chrskly/electric-mustang-bms/hardware/bms/bms.kicad_pcb

## KiCad design hardware/bms/bms.kicad_pcb (2024-02-29)

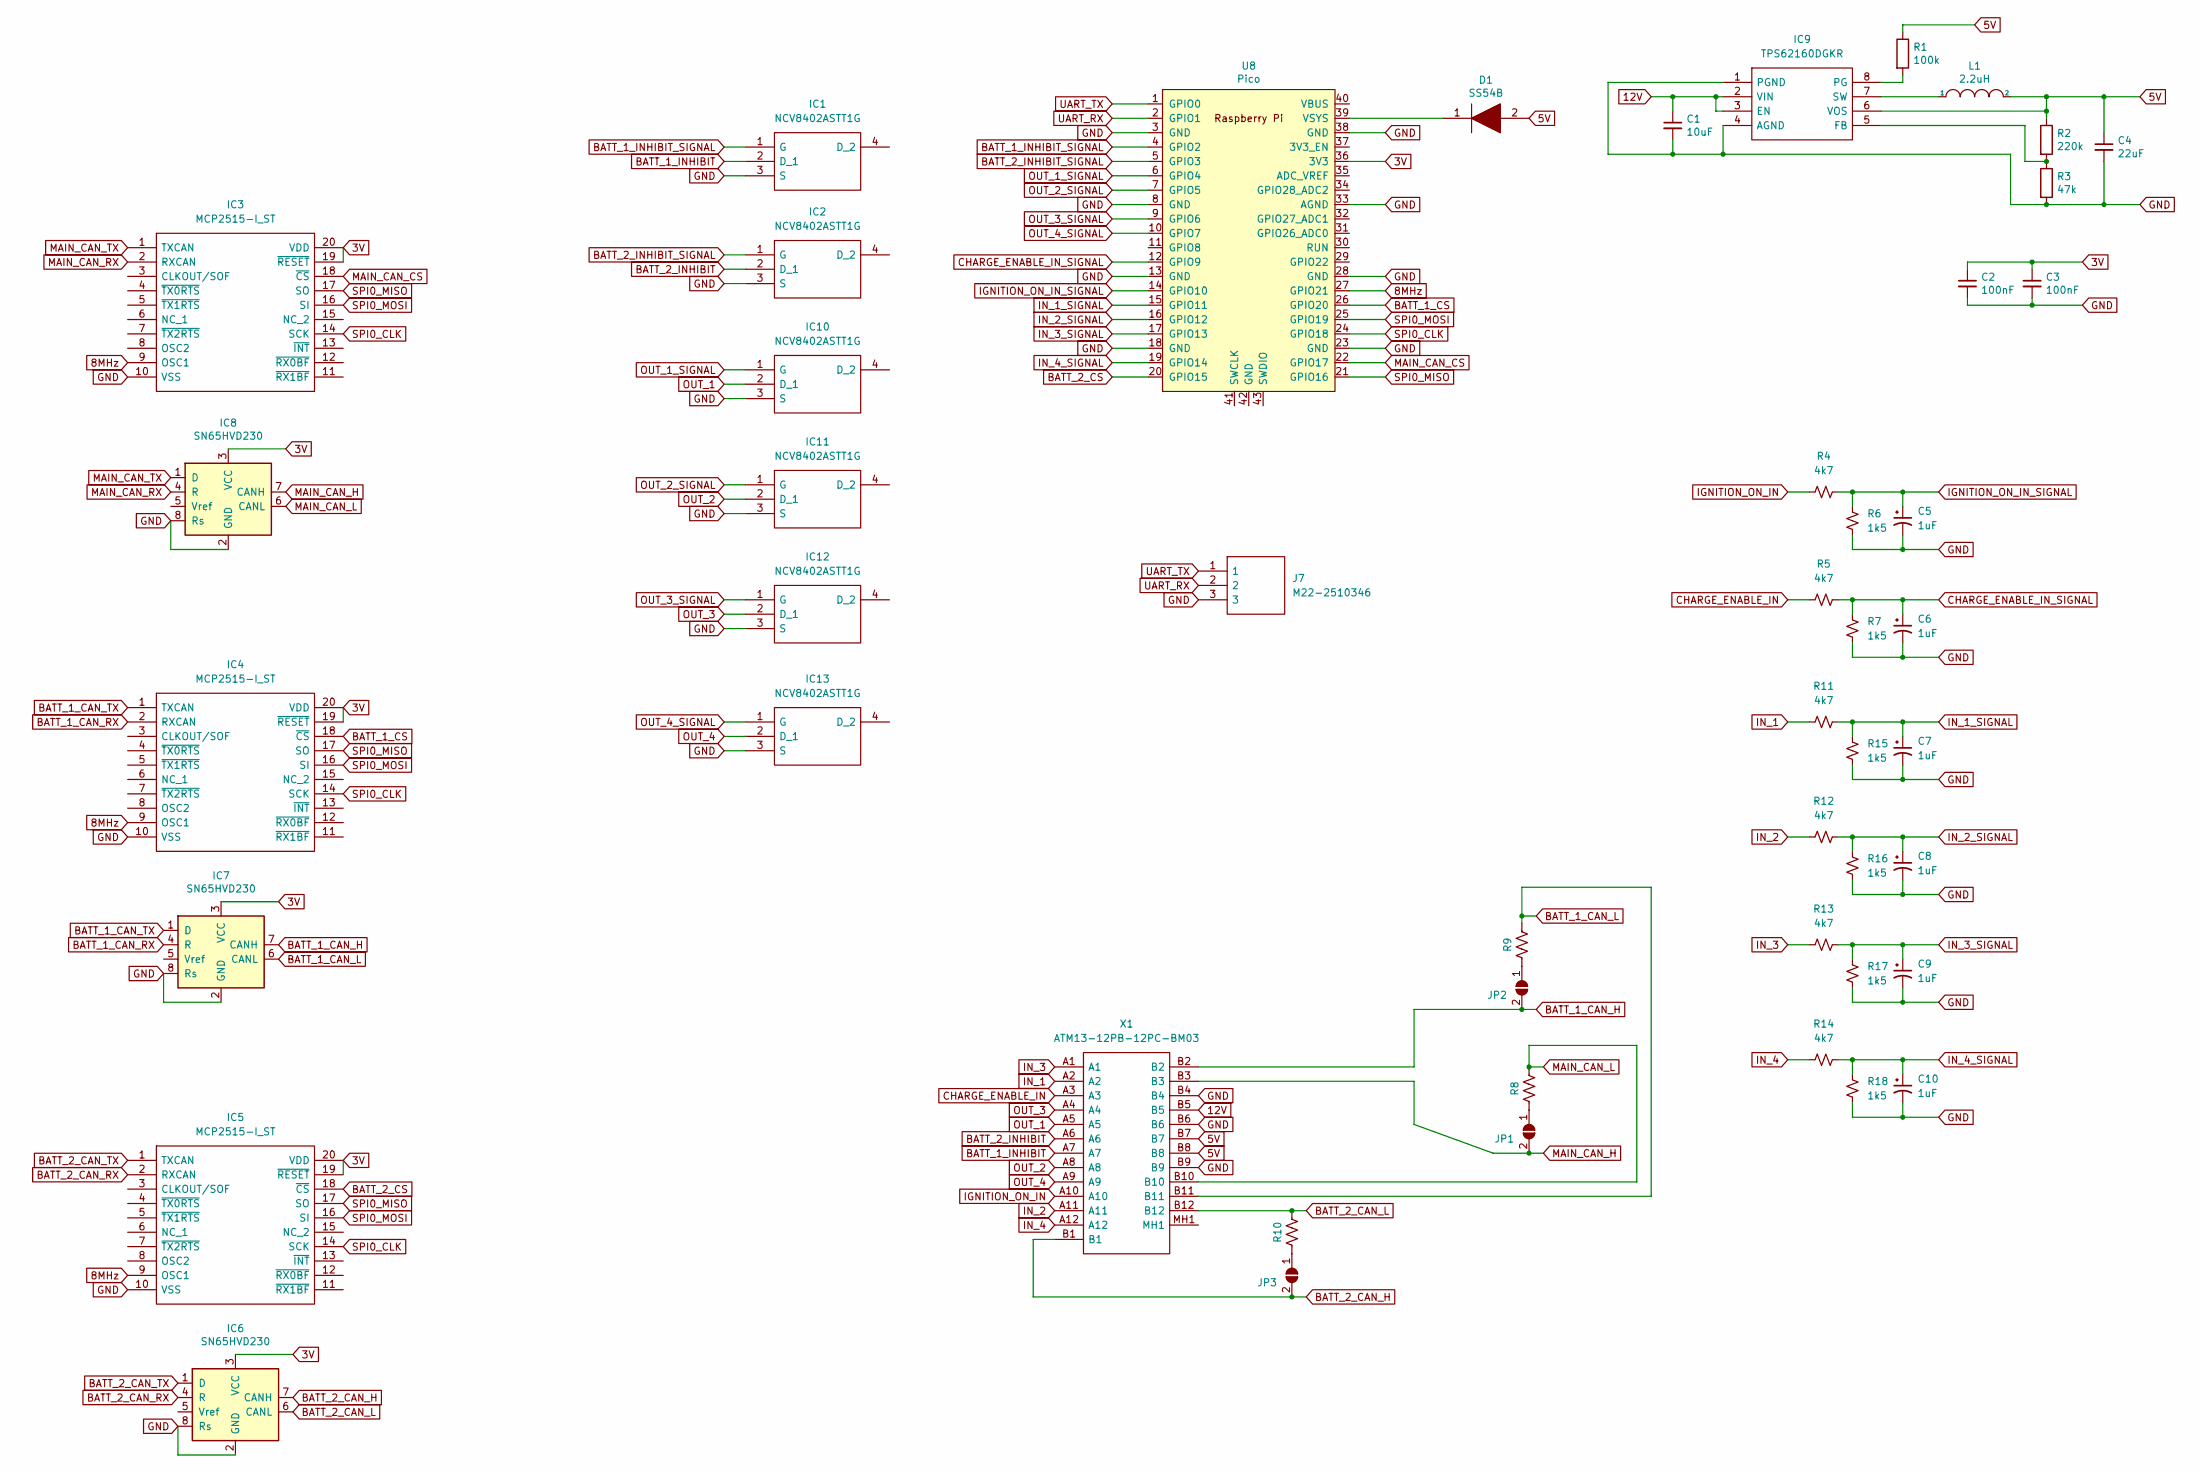
[picture p1: schematic bms.kicad_sch]

Parts:
C1: 10uF; C_0603_1608Metric
C2, C3: 100nF; C_0603_1608Metric
C4: 22uF; C_0805_2012Metric
C5, C6, C7, C8, C9, C10: 1uF; C_0603_1608Metric
D1: SS54B; DIOM5336X244N; Manufacturer_Part_Number SS54B
IC1, IC2, IC10, IC11, IC12, IC13: NCV8402ASTT1G; SOT230P700X175-4N; Manufacturer_Part_Number NCV8402ASTT1G; Mouser Part Number 863-NCV8402ASTT1G
IC3, IC4, IC5: MCP2515-I_ST; SOP65P640X120-20N; Manufacturer_Part_Number MCP2515-I/ST
IC6, IC7, IC8: SN65HVD230; SOIC-8_3.9x4.9mm_P1.27mm
IC9: TPS62160DGKR; SOP65P490X110-8N; Manufacturer_Part_Number TPS62160DGKR; Mouser Part Number 595-TPS62160DGKR
J7: M22-2510346; PinHeader_1x03_P2.54mm_Vertical; Manufacturer_Part_Number M22-2510346; Mouser Part Number 855-M22-2510346
JP1, JP2, JP3: SolderJumper_2_Open; SolderJumper-2_P1.3mm_Open_Pad1.0x1.5mm
L1: 2.2uH; NR6028T220M
R1: 100k; R_0805_2012Metric
R2: 220k; R_0805_2012Metric
R3: 47k; R_0805_2012Metric
R4, R5, R11, R12, R13, R14: 4k7; R_0805_2012Metric
R6, R7, R15, R16, R17, R18: 1k5; R_0805_2012Metric
R8, R9, R10: 120; R_0805_2012Metric
U8: Pico; RPi_Pico_SMD_TH
X1: ATM13-12PB-12PC-BM03; ATM1312PB12PCBM03; Manufacturer_Part_Number ATM13-12PB-12PC-BM03; Mouser Part Number 654-ATM1312B12PCBM03

Connections:
3V: C2.1, C3.1, IC3.19 (~RESET), IC3.20 (VDD), IC4.19 (~RESET), IC4.20 (VDD), IC5.19 (~RESET), IC5.20 (VDD), IC6.3 (VCC), IC7.3 (VCC), IC8.3 (VCC), U8.36 (3V3)
5V: C4.1, D1.2, IC9.6 (VOS), L1.2, R1.1, R2.1, X1.B7, X1.B8
8MHz: IC3.9 (OSC1), IC4.9 (OSC1), IC5.9 (OSC1), U8.27 (GPIO21)
12V: C1.1, IC9.2 (VIN), IC9.3 (EN), X1.B5
BATT_1_CAN_H: IC7.7 (CANH), JP2.2 (B), X1.B2
BATT_1_CAN_L: IC7.6 (CANL), R9.1, X1.B11
BATT_1_CAN_RX: IC4.2 (RXCAN), IC7.4 (R)
BATT_1_CAN_TX: IC4.1 (TXCAN), IC7.1 (D)
BATT_1_CS: IC4.18 (~CS), U8.26 (GPIO20)
BATT_1_INHIBIT: IC1.2 (D_1), X1.A7
BATT_1_INHIBIT_SIGNAL: IC1.1 (G), U8.4 (GPIO2)
BATT_2_CAN_H: IC6.7 (CANH), JP3.2 (B), X1.B1
BATT_2_CAN_L: IC6.6 (CANL), R10.1, X1.B12
BATT_2_CAN_RX: IC5.2 (RXCAN), IC6.4 (R)
BATT_2_CAN_TX: IC5.1 (TXCAN), IC6.1 (D)
BATT_2_CS: IC5.18 (~CS), U8.20 (GPIO15)
BATT_2_INHIBIT: IC2.2 (D_1), X1.A6
BATT_2_INHIBIT_SIGNAL: IC2.1 (G), U8.5 (GPIO3)
CHARGE_ENABLE_IN: R5.1, X1.A3
CHARGE_ENABLE_IN_SIGNAL: C6.1, R5.2, R7.1, U8.12 (GPIO9)
GND: C1.2, C2.2, C3.2, C4.2, C5.2, C6.2, C7.2, C8.2, C9.2, C10.2, IC1.3 (S), IC2.3 (S), IC3.10 (VSS), IC4.10 (VSS), IC5.10 (VSS), IC6.2 (GND), IC6.8 (Rs), IC7.2 (GND), IC7.8 (Rs), IC8.2 (GND), IC8.8 (Rs), IC9.1 (PGND), IC9.4 (AGND), IC10.3 (S), IC11.3 (S), IC12.3 (S), IC13.3 (S), J7.3, R3.2, R6.2, R7.2, R15.2, R16.2, R17.2, R18.2, U8.3 (GND), U8.8 (GND), U8.13 (GND), U8.18 (GND), U8.23 (GND), U8.28 (GND), U8.33 (AGND), U8.38 (GND), X1.B4, X1.B6, X1.B9
IGNITION_ON_IN: R4.1, X1.A10
IGNITION_ON_IN_SIGNAL: C5.1, R4.2, R6.1, U8.14 (GPIO10)
IN_1: R11.1, X1.A2
IN_1_SIGNAL: C7.1, R11.2, R15.1, U8.15 (GPIO11)
IN_2: R12.1, X1.A11
IN_2_SIGNAL: C8.1, R12.2, R16.1, U8.16 (GPIO12)
IN_3: R13.1, X1.A1
IN_3_SIGNAL: C9.1, R13.2, R17.1, U8.17 (GPIO13)
IN_4: R14.1, X1.A12
IN_4_SIGNAL: C10.1, R14.2, R18.1, U8.19 (GPIO14)
MAIN_CAN_CS: IC3.18 (~CS), U8.22 (GPIO17)
MAIN_CAN_H: IC8.7 (CANH), JP1.2 (B), X1.B3
MAIN_CAN_L: IC8.6 (CANL), R8.1, X1.B10
MAIN_CAN_RX: IC3.2 (RXCAN), IC8.4 (R)
MAIN_CAN_TX: IC3.1 (TXCAN), IC8.1 (D)
unnamed: D1.1, U8.39 (VSYS)
unnamed: IC9.5 (FB), R2.2, R3.1
unnamed: IC9.7 (SW), L1.1
unnamed: IC9.8 (PG), R1.2
unnamed: JP1.1 (A), R8.2
unnamed: JP2.1 (A), R9.2
unnamed: JP3.1 (A), R10.2
OUT_1: IC10.2 (D_1), X1.A5
OUT_1_SIGNAL: IC10.1 (G), U8.6 (GPIO4)
OUT_2: IC11.2 (D_1), X1.A8
OUT_2_SIGNAL: IC11.1 (G), U8.7 (GPIO5)
OUT_3: IC12.2 (D_1), X1.A4
OUT_3_SIGNAL: IC12.1 (G), U8.9 (GPIO6)
OUT_4: IC13.2 (D_1), X1.A9
OUT_4_SIGNAL: IC13.1 (G), U8.10 (GPIO7)
SPI0_CLK: IC3.14 (SCK), IC4.14 (SCK), IC5.14 (SCK), U8.24 (GPIO18)
SPI0_MISO: IC3.17 (SO), IC4.17 (SO), IC5.17 (SO), U8.21 (GPIO16)
SPI0_MOSI: IC3.16 (SI), IC4.16 (SI), IC5.16 (SI), U8.25 (GPIO19)
UART_RX: J7.2, U8.2 (GPIO1)
UART_TX: J7.1, U8.1 (GPIO0)

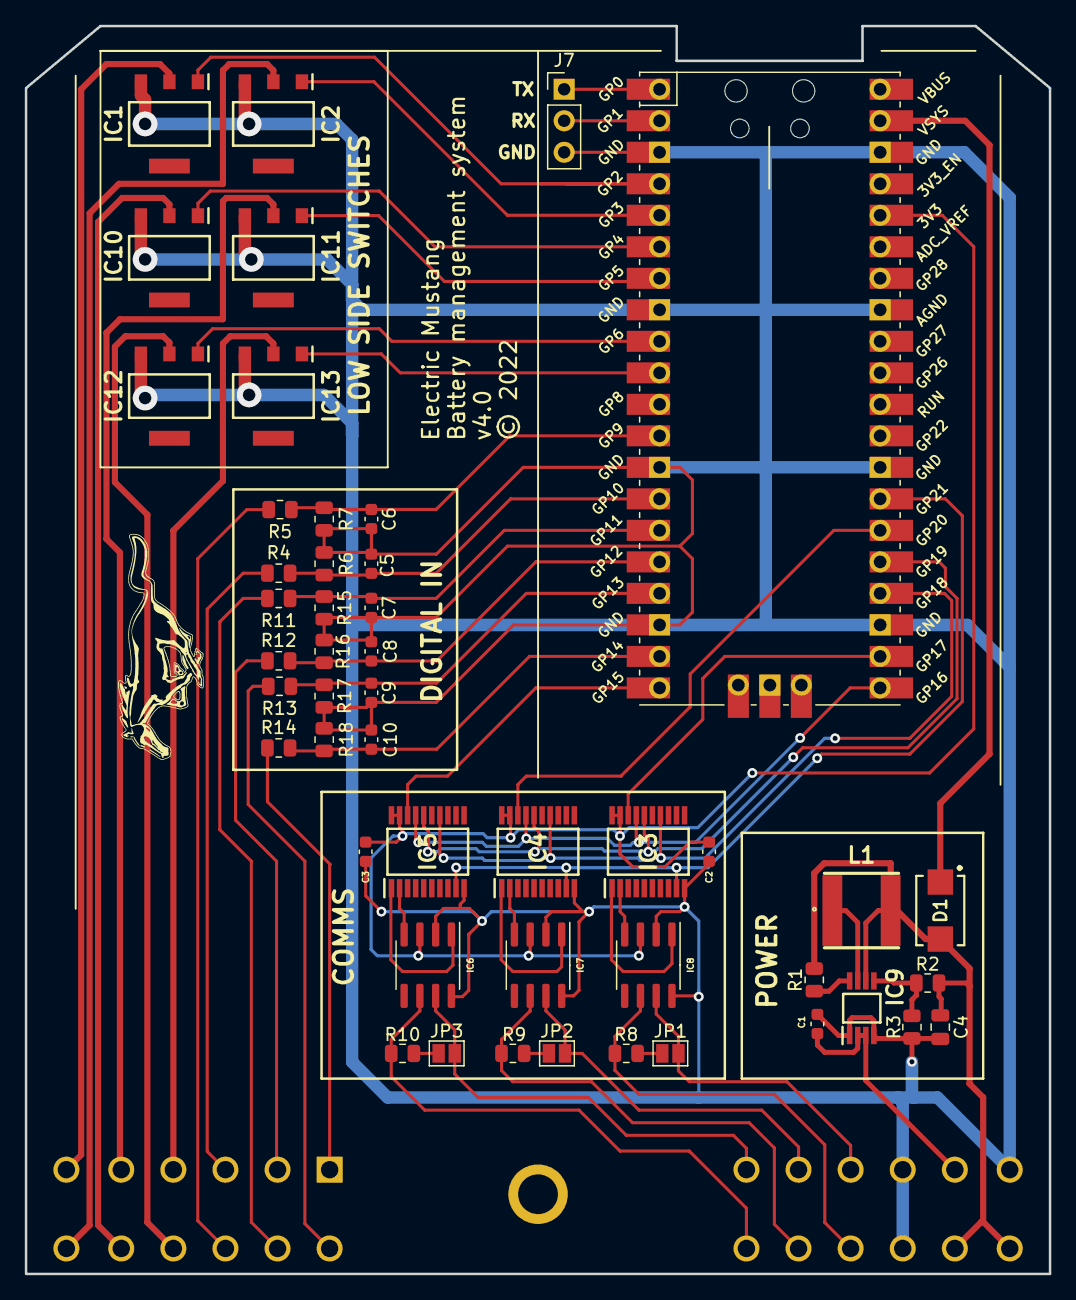
[picture p2: board bms.kicad_pcb from above]

Board: 2 copper layers, 82.6 x 100.6 mm, 49 parts (0 on the bottom side), 56 nets.
