chrskly/electric-mustang-bms/src/module.cpp

/*
 * This file is part of the ev mustang bms project.
 *
 * Copyright (C) 2024 Christian Kelly <chrskly@chrskly.com>
 *
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
 * You should have received a copy of the GNU General Public License
 * along with this program.  If not, see <http://www.gnu.org/licenses/>.
 */

/*

    MODULE

*/

#include <stdio.h>
#include <time.h>

#include "include/module.h"
#include "include/pack.h"
#include "include/util.h"


BatteryModule::BatteryModule() {}

//
BatteryModule::BatteryModule(int _id, BatteryPack* _pack, int _numCells, int _numTemperatureSensors) {
    // printf("Creating module (id:%d, pack:%d, cpm:%d, t:%d)\n", _id, _pack->id, _numCells, _numTemperatureSensors);
    id = _id;
    // Point back to parent pack
    pack = _pack;
    // Initialise all cell voltages to zero
    numCells = _numCells;
    for ( int c = 0; c < numCells; c++ ) {
        cellVoltage[c] = 0;
    }
    // Initialise temperature sensor readings to zero
    numTemperatureSensors = _numTemperatureSensors;
    for ( int t = 0; t < numTemperatureSensors; t++ ) {
        cellTemperature[t] = -127;
    }
    allModuleDataPopulated = false;
}

void BatteryModule::print() {
    // printf("    Module id : %d (numCells : %d)\n", id, numCells);
    // printf("        Cell Voltages : ");
    // for ( int c = 0; c < numCells; c++ ) {
    //     printf("%d:%umV ", c, cellVoltage[c]);
    // }
    // printf("\n");
    // printf("        Temperatures : ");
    // for ( int t = 0; t < numTemperatureSensors; t++ ) {
    //     printf("%d:%dC ", t, cellTemperature[t]);
    // }
    // printf("\n");
    printf("  %d : ", id);
    for ( int c = 0; c < numCells; c++ ) {
        printf("%u ", cellVoltage[c]);
    }
    printf("\n");
}


//// ----
//
// Voltage
//
//// ----

// Return total module voltage by summing the cell voltages
uint32_t BatteryModule::get_voltage() {
    uint32_t voltage = 0;
    for ( int c = 0; c < numCells; c++ ) {
        voltage += cellVoltage[c];
    }
    return voltage;
}

// Return the voltage of the lowest cell voltage in the module
uint16_t BatteryModule::get_lowest_cell_voltage() {
    uint16_t lowestCellVoltage = 10000;
    for ( int c = 0; c < numCells; c++ ) {
        if ( cellVoltage[c] < lowestCellVoltage ) {
            lowestCellVoltage = cellVoltage[c];
        }
    }
    return lowestCellVoltage;
}

// Return the voltage of the highest cell in the module
uint16_t BatteryModule::get_highest_cell_voltage() {
    uint16_t highestCellVoltage = 0;
    for ( int c = 0; c < numCells; c++ ) {
        if ( cellVoltage[c] > highestCellVoltage ) {
            highestCellVoltage = cellVoltage[c];
        }
    }
    return highestCellVoltage;
}

// Update the voltage for a single cell
void BatteryModule::set_cell_voltage(int cellIndex, uint16_t newCellVoltage) {
    cellVoltage[cellIndex] = newCellVoltage;
}

// Return true if any of the cells in the module are under min voltage
bool BatteryModule::has_empty_cell() {
    for ( int c = 0; c < numCells; c++ ) {
        if ( cellVoltage[c] <= CELL_EMPTY_VOLTAGE ) {
            return true;
        }
    }
    return false;
}

// Return true if any of the cells in the module are over max voltage
bool BatteryModule::has_full_cell() {
    for ( int c = 0; c < numCells; c++ ) {
        if ( cellVoltage[c] >= CELL_FULL_VOLTAGE ) {
            return true;
        }
    }
    return false;
}

/*
 * Check for dead cells in the module
 */
bool BatteryModule::has_dead_cell() {
    for ( int c = 0; c < numCells; c++ ) {
        if ( cellVoltage[c] <= DEAD_CELL_VOLTAGE ) {
            return true;
        }
    }
    return false;
}

//// ----
//
// Status
//
//// ----

// Return true if we have voltage/temp information for all cells
bool BatteryModule::all_module_data_populated() {
    return allModuleDataPopulated;
}

void BatteryModule::check_if_module_data_is_populated() {
    bool voltageMissing = false;
    for ( int c = 0; c < numCells; c++ ) {
        if ( cellVoltage[c] == 0 ) {
            voltageMissing = true;
        }
    }
    bool temperatureMissing = false;
    for ( int t = 0; t < numTemperatureSensors; t++ ) {
        if ( cellTemperature[t] < -126 ) {
            temperatureMissing = true;
        }
    }
    allModuleDataPopulated = voltageMissing && temperatureMissing;
}

bool BatteryModule::is_alive() {
    return ( ((double)(get_clock() - lastHeartbeat) / CLOCKS_PER_SEC) < MODULE_TTL );
}

void BatteryModule::heartbeat() {
    lastHeartbeat = get_clock();
}

//// ----
//
// Temperature
//
//// ----

// Update the value for one of the temperature sensors
void BatteryModule::update_temperature(int tempSensorId, uint8_t newTemperature) {
    cellTemperature[tempSensorId] = newTemperature;
}

// Return the temperature of the coldest sensor in the module
int8_t BatteryModule::get_lowest_temperature() {
    int8_t lowestTemperature = 126;
    for ( int t = 0; t < numTemperatureSensors; t++ ) {
        // Skip uninitialised readings
        if ( cellTemperature[t] < -126 ) {
            continue;
        }
        if ( cellTemperature[t] < lowestTemperature ) {
            lowestTemperature = cellTemperature[t];
        }
    }
    //printf("lowest temp : %d\n", lowestTemperature);
    return lowestTemperature;
}

// Return the temperature of the hottest sensor in the module
int8_t BatteryModule::get_highest_temperature() {
    int8_t highestTemperature = -126;
    for ( int t = 0; t < numTemperatureSensors; t++ ) {
        // Skip uninitialised readings
        if ( cellTemperature[t] < -126 ) {
            continue;
        }
        if ( cellTemperature[t] > highestTemperature ) {
            highestTemperature = cellTemperature[t];
        }
    }
    return highestTemperature;
}

// Return true if any temperature sensor is over the max temperature
bool BatteryModule::has_temperature_sensor_over_max() {
    return ( get_highest_temperature() > MAXIMUM_TEMPERATURE );
}



// returns true when any temperature sensor in this module is over the warning
// level, but below the critical level.
bool BatteryModule::temperature_at_warning_level() {
    for ( int c = 0; c < numCells; c++ ) {
        if ( cellTemperature[c] >= WARNING_TEMPERATURE && cellTemperature[c] < MAXIMUM_TEMPERATURE ) {
            return true;
        }
    }
    return false;
}
