chrskly/electric-mustang-bms/test/testcases0xx.cpp

/*
 * This file is part of the ev mustang bms project.
 *
 * Copyright (C) 2024 Christian Kelly <chrskly@chrskly.com>
 *
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
 * You should have received a copy of the GNU General Public License
 * along with this program.  If not, see <http://www.gnu.org/licenses/>.
 */

#include "include/battery.h"
#include "include/io.h"
#include "include/testcaseutils.h"

/*
 * Test cases relating battery empty/full events
 *
 * 001 : Ensure car cannot be driven when battery is empty, starting in STANDBY
 *       state.
 * 002 : Ensure car cannot be driven when battery is empty, starting in DRIVE
 *       state.
 * 003 : When battery is empty and overheating, but the temperature drops, the
 *       car should still not be drivable as the battery is still empty.
 * 004 : When battery is empty and overheating, but the SoC rises the car should
 *       still not be drivable as the battery is still too hot.
 * 005 : When battery is empty and we're charging, but the charging stops, the
 *       car should still not be drivable as the battery is still empty.
 * 006 : When battery is full, the car should not be allowed to charge. Start in
 *       STANDBY state.
 * 007 : When battery is full, the car should not be allowed to charge. Start in
 *       DRIVE state.
 * 008 : When battery is full, the car should not be allowed to charge. Start in
 *       CHARGE state.
 */


/*
 * Test case 001
 * -----------------------------------------------------------------------------
 * Description: Ensure car cannot be driven when battery is empty, starting in
 *              STANDBY state.
 * Preconditions:
 *   1. Battery is not empty
 *   2. BMS is in STANDBY state
 *   3. DRIVE_INHIBIT signal is inactive
 *   4. Temperature is normal
 *   5. Ignition is off
 * Actions:
 *   1. Set cell voltage for one cell to minV (i.e., set battery empty)
 * Postconditions:
 *   1. BMS is in batteryEmpty state
 *   2. DRIVE_INHIBIT signal is active
 */
bool test_case_001(Battery* battery, Bms* bms) {
    printf("Running test [test_case_001] : inhibit drive when battery empty, from idle state\n");

    if ( ! transition_to_standby_state(bms) ) {
        return false;
    }

    // 0% SoC
    uint16_t newCellVoltage = static_cast<uint16_t>(CELL_EMPTY_VOLTAGE);
    printf("    > Setting all cell voltages to %dmV (0%% soc)\n", newCellVoltage);
    battery->set_all_cell_voltages(newCellVoltage);

    // Make sure DRIVE_INHIBIT goes high
    printf("    > Waiting for DRIVE_INHIBIT to activate\n");
    if ( ! assert_drive_inhibit_state(bms, true) ) {
        printf("    > Test FAILED\n");
        return false;
    }

    // Make sure CAN messages show the car has switched to batteryEmpty state
    printf("    > Waiting for BMS state to change to batteryEmpty\n");
    if ( ! assert_bms_state(bms, STATE_BATTERY_EMPTY) ) {
        printf("    > Test FAILED\n");
        return false;
    }

    printf("    > Test PASSED\n");
    return true;
}

/*
 * Test case 002
 * -----------------------------------------------------------------------------
 * Description: Ensure car cannot be driven when battery is empty, starting in
 *              DRIVE state.
 * Preconditions:
 *   1. Battery is not empty
 *   2. BMS is in DRIVE state
 *   3. DRIVE_INHIBIT signal is inactive
 *   4. Temperature is normal
 *   5. Ignition is on
 * Actions:
 *   1. Set cell voltage for one cell to minV
 * Postconditions:
 *   1. BMS is in batteryEmpty state
 *   2. DRIVE_INHIBIT signal is active
 */
bool test_case_002(Battery* battery, Bms* bms) {
    printf("Running test [test_case_002] : inhibit drive when battery empty, from drive state\n");

    if ( ! transition_to_drive_state(bms) ) {
        return false;
    }

    // 0% SoC
    uint16_t newCellVoltage = static_cast<uint16_t>(CELL_EMPTY_VOLTAGE);
    printf("    > Setting all cell voltages to %dmV (0%% soc)\n", newCellVoltage);
    battery->set_all_cell_voltages(newCellVoltage);

    // Make sure DRIVE_INHIBIT goes high
    printf("    > Waiting for DRIVE_INHIBIT to activate\n");
    if ( ! assert_drive_inhibit_state(bms, true) ) {
        printf("    > Test FAILED\n");
        return false;
    }

    // Make sure CAN messages show the car has switched to batteryEmpty state
    printf("    > Waiting for BMS state to change to batteryEmpty\n");
    if ( ! assert_bms_state(bms, STATE_BATTERY_EMPTY) ) {
        printf("    > Test FAILED\n");
        return false;
    }

    printf("    > Test PASSED\n");
    return true;

}

/*
 * Test case 003
 * -----------------------------------------------------------------------------
 * Description: When battery is empty and overheating, but the temperature
 *              drops, the car should still not be drivable as the battery is
 *              still empty.
 * Preconditions:
 *   1. Battery is empty
 *   2. BMS is in overTemp state
 *   3. DRIVE_INHIBIT signal is active
 *   4. Temperature is high
 * Actions:
 *   1. Set temperature to normal value
 * Postconditions:
 *   1. BMS is in batteryEmpty state
 *   2. DRIVE_INHIBIT signal is still active
 */
bool test_case_003(Battery* battery, Bms* bms) {
    printf("Running test [test_case_003] : empty battery, high temp drops\n");

    if ( ! transition_to_standby_state(bms) ) {
        return false;
    }

    // 0% SoC
    uint16_t newCellVoltage = static_cast<uint16_t>(CELL_EMPTY_VOLTAGE);
    printf("    > Setting all cell voltages to %dmV (0%% soc)\n", newCellVoltage);
    battery->set_all_cell_voltages(newCellVoltage);

    // Make sure DRIVE_INHIBIT goes high
    printf("    > Waiting for DRIVE_INHIBIT to activate\n");
    if ( ! assert_drive_inhibit_state(bms, true) ) {
        printf("    > Test FAILED\n");
        return false;
    }

    // Set the temperature to 51C
    printf("    > Setting all temperatures to 51C\n");
    battery->set_all_temperatures(51);

    // wait for overTemp state
    printf("    > Waiting for BMS state to change to overTemp\n");
    if ( ! assert_bms_state(bms, STATE_OVER_TEMP_FAULT) ) {
        printf("    > Test FAILED\n");
        return false;
    }

    // Set the temperature to 20C
    printf("    > Setting all temperatures to 20C\n");
    battery->set_all_temperatures(20);

    // Make sure CAN messages show the car has switched to batteryEmpty state
    printf("    > Waiting for BMS state to change to batteryEmpty\n");
    if ( ! assert_bms_state(bms, STATE_BATTERY_EMPTY) ) {
        printf("    > Test FAILED\n");
        return false;
    }

    // Make sure DRIVE_INHIBIT stays high
    printf("    > Waiting for DRIVE_INHIBIT to activate\n");
    if ( ! assert_drive_inhibit_state(bms, true) ) {
        printf("    > Test FAILED\n");
        return false;
    }

    printf("    > Test PASSED\n");
    return true;

}

/*
 * Test case 004
 * -----------------------------------------------------------------------------
 * Description: When battery is empty and overheating, but the SoC rises the car
 *              should still not be drivable as the battery is still too hot.
 *
 * Preconditions:
 *   1. Battery is empty
 *   2. BMS is in overTemp state
 *   3. DRIVE_INHIBIT signal is active
 *   4. Temperature is high
 * Actions:
 *   1. Set battery SoC to 50%
 * Postconditions:
 *   1. BMS is in overTemp state
 *   2. DRIVE_INHIBIT signal is still active
 */
bool test_case_004(Battery* battery, Bms* bms) {
    printf("Running test [test_case_004] : high temp, empty battery, SoC rises\n");

    if ( ! transition_to_standby_state(bms) ) {
        return false;
    }

    // 0% SoC
    uint16_t newCellVoltage = static_cast<uint16_t>(CELL_EMPTY_VOLTAGE);
    printf("    > Setting all cell voltages to %dmV (0%% soc)\n", newCellVoltage);
    battery->set_all_cell_voltages(newCellVoltage);

    // Make sure DRIVE_INHIBIT goes high
    printf("    > Waiting for DRIVE_INHIBIT to activate\n");
    if ( ! assert_drive_inhibit_state(bms, true) ) {
        printf("    > Test FAILED\n");
        return false;
    }

    // Set the temperature to 51C
    printf("    > Setting all temperatures to 51C\n");
    battery->set_all_temperatures(51);

    // wait for overTemp state
    printf("    > Waiting for BMS state to change to overTemp\n");
    if ( ! assert_bms_state(bms, STATE_OVER_TEMP_FAULT) ) {
        printf("    > Test FAILED\n");
        return false;
    }

    // 50% SoC
    newCellVoltage = battery->get_voltage_from_soc(50);
    printf("    > Setting all cell voltages to %dmV (0%% soc)\n", newCellVoltage);
    battery->set_all_cell_voltages(newCellVoltage);

    // Make sure CAN messages show the car has switched to overTemp state
    printf("    > Waiting for BMS state to change to overTemp\n");
    if ( ! assert_bms_state(bms, STATE_OVER_TEMP_FAULT) ) {
        printf("    > Test FAILED\n");
        return false;
    }

    // Make sure DRIVE_INHIBIT stays high
    printf("    > Waiting for DRIVE_INHIBIT to activate\n");
    if ( ! assert_drive_inhibit_state(bms, true) ) {
        printf("    > Test FAILED\n");
        return false;
    }

    printf("    > Test PASSED\n");
    return true;

}

/*
 * Test case 005
 * -----------------------------------------------------------------------------
 * Description: When battery is empty and we're charging, but the charging
 *              stops, the car should still not be drivable as the battery is
 *              still empty.
 * Preconditions:
 *   1. Battery is empty
 *   2. BMS is in STANDBY state
 *   3. DRIVE_INHIBIT signal is inactive
 *   4. Temperature is normal
 * Actions:
 *   1. Start charging
 *   2. Stop charging
 * Postconditions:
 *   1. BMS is in batteryEmpty state
 *   2. DRIVE_INHIBIT signal is still active
 */
bool test_case_005(Battery* battery, Bms* bms) {
    printf("Running test [test_case_005] : empty battery, charging terminates\n");

    if ( ! transition_to_standby_state(bms) ) {
        return false;
    }

    // 0% SoC
    uint16_t newCellVoltage = static_cast<uint16_t>(CELL_EMPTY_VOLTAGE);
    printf("    > Setting all cell voltages to %dmV (0%% soc)\n", newCellVoltage);
    battery->set_all_cell_voltages(newCellVoltage);

    // Make sure DRIVE_INHIBIT goes high
    printf("    > Waiting for DRIVE_INHIBIT to activate\n");
    if ( ! assert_drive_inhibit_state(bms, true) ) {
        printf("    > Test FAILED\n");
        return false;
    }

    // Make sure CAN messages show the car has switched to batteryEmpty state
    printf("    > Waiting for BMS state to change to batteryEmpty\n");
    if ( ! assert_bms_state(bms, STATE_BATTERY_EMPTY) ) {
        printf("    > Test FAILED\n");
        return false;
    }

    // Start charging
    set_charge_enable_state(true);

    // wait for BMS to go into CHARGING state
    printf("    > Waiting for BMS state to change to CHARGING\n");
    if ( ! assert_bms_state(bms, STATE_CHARGING) ) {
        printf("    > Test FAILED\n");
        return false;
    }

    // Stop charging
    set_charge_enable_state(false);

    // wait for BMS to go into batteryEmpty state
    printf("    > Waiting for BMS state to change to batteryEmpty\n");
    if ( ! assert_bms_state(bms, STATE_BATTERY_EMPTY) ) {
        printf("    > Test FAILED\n");
        return false;
    }

    // Make sure DRIVE_INHIBIT is still active
    if ( ! assert_drive_inhibit_state(bms, true) ) {
        printf("    > Test FAILED\n");
        return false;
    }

    printf("    > Test PASSED\n");
    return true;

}

/*
 * Test case 006
 * -----------------------------------------------------------------------------
 * Description: When battery is full, the car should not be allowed to charge.
 *              Start in STANDBY state.
 * Preconditions:
 *   1. BMS is in STANDBY state
 *   2. DRIVE_INHIBIT signal is inactive
 *   3. Temperature is normal
 * Actions:
 *   1. Set cell voltage for one cell to maxV (i.e., set battery full)
 * Postconditions:
 *   1. BMS is in STANDBY state
 *   2. CHARGE_INHIBIT signal is active
 */
bool test_case_006(Battery* battery, Bms* bms) {
    printf("Running test [test_case_006] : battery full, disallow charge, from idle state\n");

    if ( ! transition_to_standby_state(bms) ) {
        return false;
    }

    // 100% SoC
    uint16_t newCellVoltage = static_cast<uint16_t>(CELL_FULL_VOLTAGE+10);
    printf("    > Setting all cell voltages to %dmV (100%% soc)\n", newCellVoltage);
    battery->set_all_cell_voltages(newCellVoltage);

    // Make sure CHARGE_INHIBIT goes high
    printf("    > Waiting for CHARGE_INHIBIT to activate\n");
    if ( ! assert_charge_inhibit_state(bms, true) ) {
        printf("    > Test FAILED\n");
        return false;
    }

    return true;
}

/*
 * Test case 007
 * -----------------------------------------------------------------------------
 * Description: When battery is full, the car should not be allowed to charge.
 *              Start in DRIVE state.
 * Preconditions:
 *   1. BMS is in DRIVE state
 *   2. DRIVE_INHIBIT signal is inactive
 *   3. Temperature is normal
 * Actions:
 *   1. Set cell voltage for one cell to maxV (i.e., set battery full)
 * Postconditions:
 *   1. BMS is in DRIVE state
 *   2. CHARGE_INHIBIT signal is active
 */
bool test_case_007(Battery* battery, Bms* bms) {
    printf("Running test [test_case_007] : battery full disallow charge, from drive state\n");

    if ( ! transition_to_drive_state(bms) ) {
        return false;
    }

    // 100% SoC
    uint16_t newCellVoltage = static_cast<uint16_t>(CELL_FULL_VOLTAGE+10);
    printf("    > Setting all cell voltages to %dmV (100%% soc)\n", newCellVoltage);
    battery->set_all_cell_voltages(newCellVoltage);

    // Make sure CHARGE_INHIBIT goes high
    printf("    > Waiting for CHARGE_INHIBIT to activate\n");
    if ( ! assert_charge_inhibit_state(bms, true) ) {
        printf("    > Test FAILED\n");
        return false;
    }

    printf("    > Test PASSED\n");
    return true;
}

// when charging, if the battery is full, the charge inhibit signal should be active

/*
 * Test case 008
 * -----------------------------------------------------------------------------
 * Description: When battery is full, the car should not be allowed to charge.
 *              Start in CHARGE state.
 * Preconditions:
 *   1. BMS is in CHARGE state
 *   2. DRIVE_INHIBIT signal is inactive
 *   3. Temperature is normal
 * Actions:
 *   1. Set cell voltage for one cell to maxV (i.e., set battery full)
 * Postconditions:
 *   1. BMS is in DRIVE state
 *   2. CHARGE_INHIBIT signal is active
 */
bool test_case_008(Battery* battery, Bms* bms) {
    printf("Running test [test_case_008] : battery full disallow charge, from charge state\n");

    if ( ! transition_to_charging_state(bms) ) {
        return false;
    }

    // 100% SoC
    uint16_t newCellVoltage = static_cast<uint16_t>(CELL_FULL_VOLTAGE+10);
    printf("    > Setting all cell voltages to %dmV (100%% soc)\n", newCellVoltage);
    battery->set_all_cell_voltages(newCellVoltage);

    // Make sure CHARGE_INHIBIT goes high
    printf("    > Waiting for CHARGE_INHIBIT to activate\n");
    if ( ! assert_charge_inhibit_state(bms, true) ) {
        printf("    > Test FAILED\n");
        return false;
    }

    printf("    > Test PASSED\n");
    return true;
}
