chrskly/electric-mustang-bms/test/testcaseutils.cpp

/*
 * This file is part of the ev mustang bms project.
 *
 * Copyright (C) 2024 Christian Kelly <chrskly@chrskly.com>
 *
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
 * You should have received a copy of the GNU General Public License
 * along with this program.  If not, see <http://www.gnu.org/licenses/>.
 */


#include <time.h>
#include <string>
#include "include/util.h"
#include "include/bms.h"
#include "include/battery.h"
#include "include/io.h"



bool wait_for_soc(Bms* bms, int soc, int timeout) {
    clock_t startTime = get_clock();
    while (bms->get_soc() < soc) {
        if (get_clock() - startTime > timeout) {
            return false;
        }
    }
    return true;
}

/*
 * Wait for drive inhibit state to change. Specify whether you're waiting for it
 * to be active (true) or inactive (false) by setting the `state` param. Fail
 * out if it has not changed within `timeout` ms.
 */
bool wait_for_drive_inhibit_state(Bms* bms, bool state, int timeout) {
    clock_t startTime = get_clock();
    while (bms->get_inhibitDrive() != state) {
        std::string currentDriveState = bms->get_inhibitDrive() ? "true" : "false";
        std::string currentChargeState = bms->get_inhibitCharge() ? "true" : "false";
        if ( get_clock() % 1000 == 0 ){
            printf("    * Drive inhibit state: %s\n", currentDriveState.c_str());
            printf("    * Charge inhibit state: %s\n", currentChargeState.c_str());
        }
        if (get_clock() - startTime > timeout) {
            return false;
        }
    }
    return true;
}

bool assert_drive_inhibit_state(Bms* bms, bool state) {
    std::string desiredState = state ? "active" : "inactive";
    if (wait_for_drive_inhibit_state(bms, state, 2000)) {
        printf("    > DRIVE_INHIBIT transitioned to state %s\n", desiredState.c_str());
        return true;
    } else {
        printf("    > DRIVE_INHIBIT did NOT transistion to state %s\n", desiredState.c_str());
        return false;
    }
}

/*
 * Wait for charge inhibit state to change. Specify whether you're waiting for
 * it to be active (true) or inactive (false) by setting the `state` param. Fail
 * out if it has not changed within `timeout` ms.
 */
bool wait_for_charge_inhibit_state(Bms* bms, bool state, int timeout) {
    clock_t startTime = get_clock();
    while (bms->get_inhibitCharge() != state) {
        std::string currentDriveState = bms->get_inhibitDrive() ? "true" : "false";
        std::string currentChargeState = bms->get_inhibitCharge() ? "true" : "false";
        if ( get_clock() % 1000 == 0 ){
            printf("    * Drive inhibit state: %s\n", currentDriveState.c_str());
            printf("    * Charge inhibit state: %s\n", currentChargeState.c_str());
        }
        if (get_clock() - startTime > timeout) {
            return false;
        }
    }
    return true;
}

bool assert_charge_inhibit_state(Bms* bms, bool state) {
    std::string desiredState = state ? "active" : "inactive";
    if (wait_for_charge_inhibit_state(bms, state, 2000)) {
        printf("    > CHARGE_INHIBIT transitioned to state %s\n", desiredState.c_str());
        return true;
    } else {
        printf("    > CHARGE_INHIBIT did NOT transistion to state %s\n", desiredState.c_str());
        return false;
    }
}

bool wait_for_bms_state(Bms* bms, BmsState state, int timeout) {
    clock_t startTime = get_clock();
    while (bms->get_state() != state) {
        //printf("Comparing %d to %d\n", bms->get_state(), state);
        if (get_clock() - startTime > timeout) {
            return false;
        }
    }
    return true;
}

bool assert_bms_state(Bms* bms, BmsState state) {
    if (wait_for_bms_state(bms, state, 2000)) {
        printf("    > BMS state transitioned to state %d\n", state);
        return true;
    } else {
        printf("    > BMS state did NOT transistion to state %d\n", state);
        return false;
    }
}

bool wait_for_batt_inhibit_state(Battery* battery, int packId, bool state, int timeout) {
    clock_t startTime = get_clock();
    while (battery->get_pack(packId)->get_inhibit() != state) {
        if (get_clock() - startTime > timeout) {
            return false;
        }
    }
    return true;
}

bool wait_for_packs_imbalanced_state(Bms* bms, bool state, int timeout) {
    clock_t startTime = get_clock();
    while (bms->get_packsImbalanced() != state) {
        if (get_clock() - startTime > timeout) {
            return false;
        }
    }
    return true;
}

bool wait_for_heater_enable_state(Bms* bms, bool state, int timeout) {
    clock_t startTime = get_clock();
    while (bms->get_heaterEnabled() != state) {
        if (get_clock() - startTime > timeout) {
            return false;
        }
    }
    return true;
}

bool assert_heater_enable_state(Bms* bms, bool state) {
    std::string desiredState = state ? "active" : "inactive";
    if (wait_for_heater_enable_state(bms, state, 2000)) {
        printf("    > HEATER_ENABLE transitioned to state %s\n", desiredState.c_str());
        return true;
    } else {
        printf("    > HEATER_ENABLE did NOT transistion to state %s\n", desiredState.c_str());
        return false;
    }
}


bool transition_to_standby_state(Bms* bms) {
    // Set SoC to 50%
    uint16_t newCellVoltage = bms->get_battery()->get_voltage_from_soc(50);
    printf("    > Setting all cell voltages to %dmV (approx 50%% soc)\n", newCellVoltage);
    bms->get_battery()->set_all_cell_voltages(newCellVoltage);
    // Wait for all battery inhibit signals to disable
    for ( int p = 0; p < bms->get_battery()->get_num_packs(); p++ ) {
        printf("    > Waiting for BATT%d_INHIBIT to deactivate\n", p+1);
        if ( ! wait_for_batt_inhibit_state(bms->get_battery(), p, false, 2000) ) {
            printf("    > BATT%d_INHIBIT did not deactivate in time\n", p+1);
            printf("    > Test FAILED\n");
            return false;
        }
    }
    // Turn off ignition and charging
    printf("    > Turning off ignition\n");
    set_ignition_state(false);
    printf("    > Turning off charge\n");
    set_charge_enable_state(false);
    // Ensure DRIVE_INHIBIT is disabled
    printf("    > Waiting for DRIVE_INHIBIT to deactivate\n");
    if ( ! assert_drive_inhibit_state(bms, false) ) {
        printf("    > Test FAILED\n");
        return false;
    }
    // Make sure CHARGE_INHIBIT is disabled
    printf("    > Waiting for CHARGE_INHIBIT to deactivate\n");
    if ( ! assert_charge_inhibit_state(bms, false) ) {
        printf("    > Test FAILED\n");
        return false;
    }
    // Set temperature to something normal
    printf("    > Setting all temperatures to 20C\n");
    bms->get_battery()->set_all_temperatures(20);
    if ( ! assert_bms_state(bms, STATE_STANDBY) ) {
        printf("    > Test FAILED\n");
        return false;
    }
    return true;
}

bool transition_to_drive_state(Bms* bms) {
    // Set SoC to 50%
    uint16_t newCellVoltage = bms->get_battery()->get_voltage_from_soc(50);
    printf("    > Setting all cell voltages to %dmV (approx 50%% soc)\n", newCellVoltage);
    bms->get_battery()->set_all_cell_voltages(newCellVoltage);
    // Wait for all battery inhibit signals to disable
    for ( int p = 0; p < bms->get_battery()->get_num_packs(); p++ ) {
        printf("    > Waiting for BATT%d_INHIBIT to deactivate\n", p+1);
        if ( ! wait_for_batt_inhibit_state(bms->get_battery(), p, false, 2000) ) {
            printf("    > BATT%d_INHIBIT did not deactivate in time\n", p+1);
            printf("    > Test FAILED\n");
            return false;
        }
    }
    // Turn on ignition
    printf("    > Turning on ignition\n");
    set_ignition_state(true);
    printf("    > Turning off charge\n");
    set_charge_enable_state(false);
    // Ensure DRIVE_INHIBIT is disabled
    printf("    > Waiting for DRIVE_INHIBIT to deactivate\n");
    if ( ! assert_drive_inhibit_state(bms, false) ) {
        printf("    > Test FAILED\n");
        return false;
    }
    // Make sure CHARGE_INHIBIT is disabled
    printf("    > Waiting for CHARGE_INHIBIT to deactivate\n");
    if ( ! assert_charge_inhibit_state(bms, false) ) {
        printf("    > Test FAILED\n");
        return false;
    }
    // Set temperature to something normal
    printf("    > Setting all temperatures to 20C\n");
    bms->get_battery()->set_all_temperatures(20);
    if ( ! assert_bms_state(bms, STATE_DRIVE) ) {
        printf("    > Test FAILED\n");
        return false;
    }
    return true;
}

bool transition_to_charging_state(Bms* bms) {
    transition_to_standby_state(bms);

    // Start charging
    printf("    > Start charging\n");
    set_charge_enable_state(true);
    if ( ! wait_for_bms_state(bms, STATE_CHARGING, 2000) ) {
        printf("    > BMS state did not change to 'charging' in time\n");
        printf("    > Test FAILED\n");
        return false;
    }

    return true;
}
