chrskly/electric-mustang-bms/(commit log)

2024-02-29 Split out from other repo
    [bms-B_Cu.gbl, bms-B_Mask.gbs, bms-B_Paste.gbp, bms-B_Silkscreen.gbo, bms-Edge_Cuts.gm1, bms-F_Cu.gtl, bms-F_Mask.gts, bms-F_Paste.gtp]
2024-03-03 Add module heartbeat. Move module polling under battery.c. Add BMS status CAN message.
2024-03-10 Early flagging of too cold to charge
2024-03-27 start doing some safety/sanity checks and report this as a status bit in the BMS status msg. Reorganise some of the temperature thresholds
2024-03-29 Add status bit to BMS status message to indicate when packs are imbalanced
2024-04-20 Watchdog numbers the wrong way around
    [bms.cpp]
2024-04-20 Store voltages in mV because that's how we're getting from the BMS
2024-04-20 Fix format for sending mock cell voltages
    [module.cpp, module.h, pack.cpp, pack.h]
2024-04-20 Print state on serial console
2024-04-20 Transmit mock temperature data
2024-04-24 Fleshing out the test framework some more
2024-04-27 Add input handling for CHARGE_INHIBIT and DRIVE_INHIBIT
2024-05-04 Work on test case 102 and 103
2024-05-04 typo, we can only get out of illegalStateTransitionFault when both ignition and charge are off
2024-05-20 Fix bms.set_state
2024-05-20 Using wrong pin
2024-05-26 Fix up charge/drive inhibit logic
    [battery.cpp, bms.cpp, bms.h, main.cpp, statemachine.cpp]
2024-05-26 Working getting test case 002 to pass
2024-06-24 Fix test case 101
    [bms.cpp]
2024-07-07 Add xor checksum to bms frames
2024-07-13 Add temperature derating for charging.
2024-07-14 Add safeties to statemachine and rework a bit
    [statemachine.cpp]
2024-07-14 Add charge inhibit reason
2024-07-16 Fix fn naming confusion
    [battery.cpp, battery.h, statemachine.cpp]
2024-07-22 Add welded contactor detection
2024-07-28 Set temp at start of test 001 in case we've come from a test which sets overtemp
2024-07-28 make pass/fail easier to read
    [testcases1xx.cpp, testcases2xx.cpp]
2024-07-28 Only report on heater/enable when changing state
2024-07-28 Not allowing contactors to close when packs imbalanced going into charge mode
2024-07-28 Fix up full/empty battery tests
    [testcases0xx.cpp, testcaseutils.cpp]
2024-07-28 Deal with equalised packs when charging
2024-10-12 Rework 0xx test cases. Add a couple more empty/full tests. Refactor.
    [bmstest.cpp, testcases0xx.cpp, testcases0xx.h, testcaseutils.cpp, testcaseutils.h]
2025-01-03 Fold InhibitReason into drive_inhibit and charge_inhibit functions to make statemachine easier to read
2025-01-07 Split max charge current into by_temp and by_soc
2025-01-07 Make test case comments uniform. Add some more tests
2025-01-21 Missing battery full health check
    [bms.cpp]
2025-01-21 Fix reporting of state in CAN messages
    [bms.cpp]
2025-01-27 Make error messages a little clearer
    [bms.cpp]
2025-01-27 Missing criticalFault when setting light blink pattern
    [bms.cpp]
2025-02-01 Keep track of CAN errors in sending messages to modules
    [pack.cpp, pack.h]
2025-02-01 Add error counters for rx/tx on main CAN bus
    [bms.cpp, bms.h, pack.cpp]
2025-02-01 Add counters for tx/rx on main CAN bus
2025-02-02 Move charge current calculation in to generic timer so we have it all the time. Move SoC calculation here too.
2025-02-16 Take inhibitited pack into account when calculating max charge current
2025-09-07 CHARGE_INHIBIT can be on in charging state
